davidargor/BotRoby/Hardware/Power/README.md

# Power supply and charging

[Italiano](README_it.md)

The power supply module consists of two parts:
- one responsible for charging the battery
- a pair of step-down modules to power the microcontroller and microprocessor boards (two are used to guarantee a 3A peak current per board)

<center>
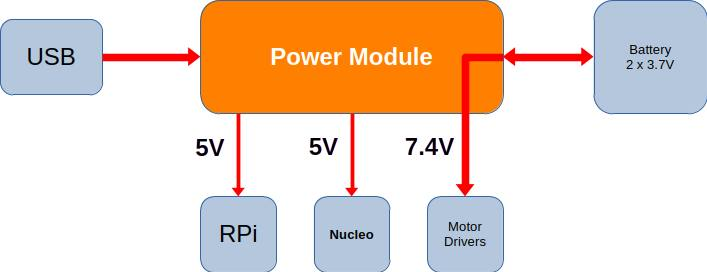
[picture p6: Hardware/Power/power_module_system_schematic.jpg]
power supply module schematic

</center>

Two rechargeable 3.7V batteries were used as the power source.
<center>
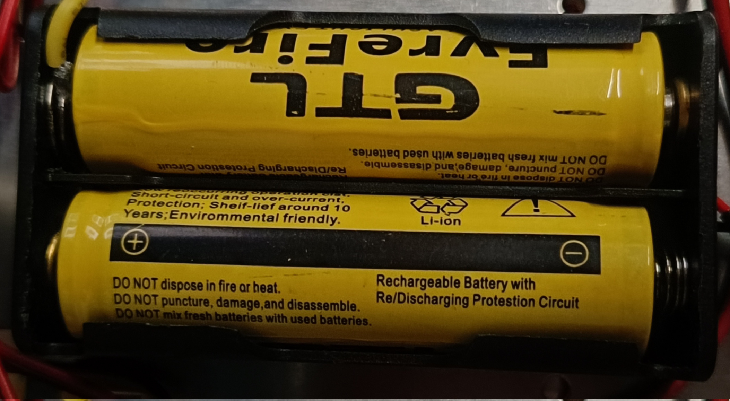
[picture p7: Hardware/Power/Batteries.jpg]
batteries

</center>

## Battery charging module

https://it.aliexpress.com/item/1005012647494433.html

- 2S and 3S lithium battery charging boost module
- Type-C USB BMS 15W 8.4V 12.6V 1.5A max
- support for fast balanced charging
- provision for a charge indicator

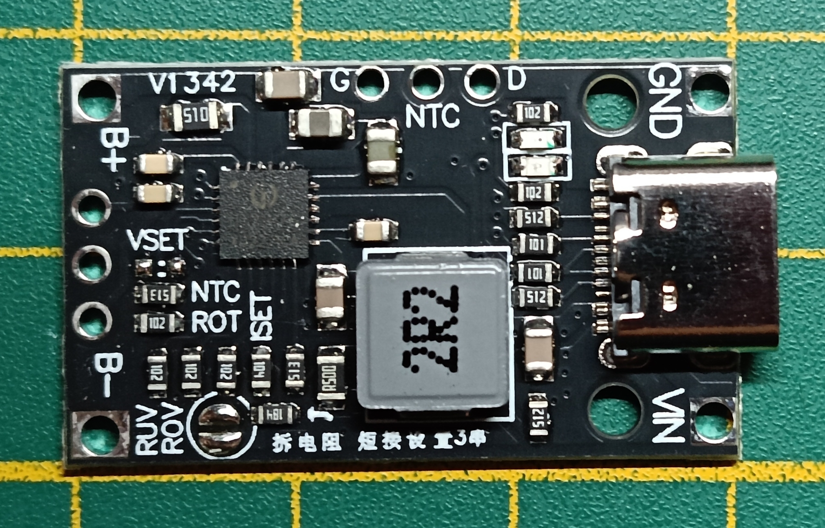
[picture p8: Hardware/Power/battery_charger_module.jpg]
battery charging module


## MP1584 Step-Down DC-DC module

- Ultra-compact **MP1584EN** step-down DC-DC power module
- Adjustable **Buck** converter up to **3A**
- Regulated power supply with high precision

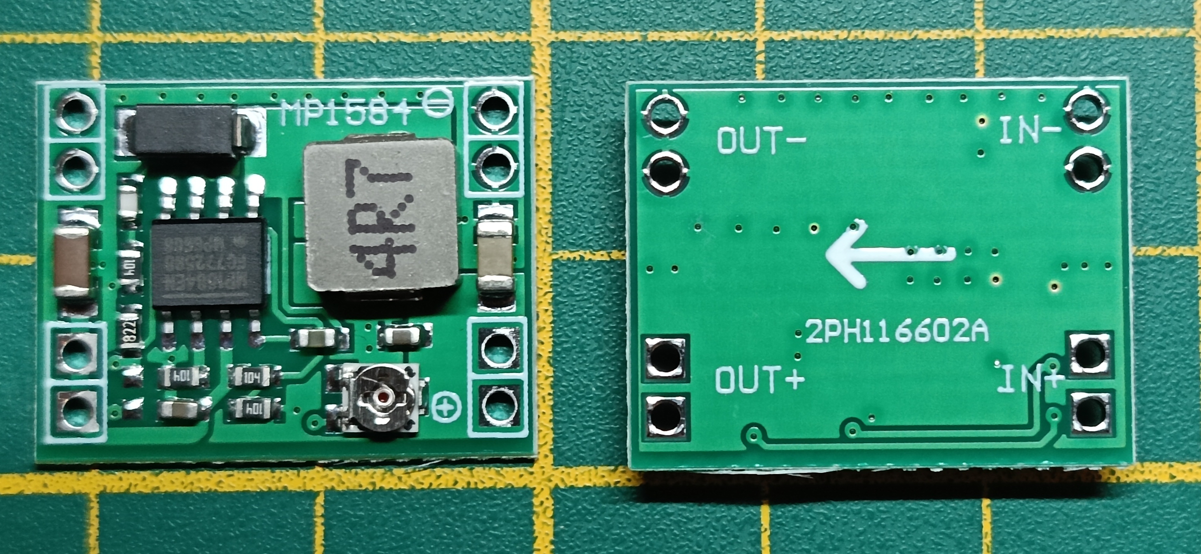
[picture p9: Hardware/Power/step_down_module.jpg]
step-down module


## Connections of the two modules and the battery

As a whole, the module has as inputs the two poles of the battery pair (+ and -) plus the center pole (2S balance / Battery_m); as outputs, it has the pairs of 5V connector outputs.

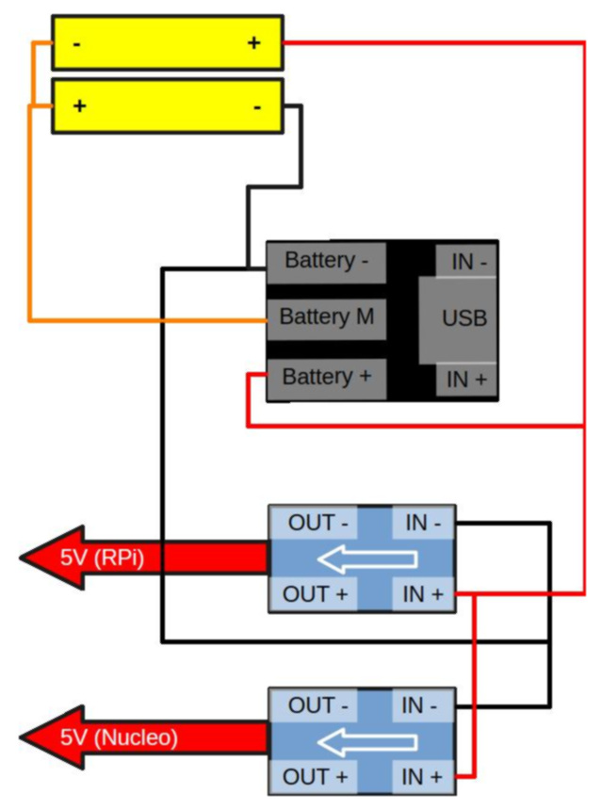
[picture p10: Hardware/Power/power_module_wiring_diagram.jpg]
power module connection diagram
<center>power module interface connections</center>
