davidargor/BotRoby/(commit log)

2026-10-18 fixed `Nucleo-RPi_perfboard_links_(solder_side).jpg`
2026-11-12 added shutdown button to RPi WEB UI
2026-11-12 Update README.md
    Updated username references in README for Raspberry Pi setup.
